bonosedidakit-glitch/DIDAKIT/DIDAKIT_SLDPRT_STL/base taleable2.SLDPRT

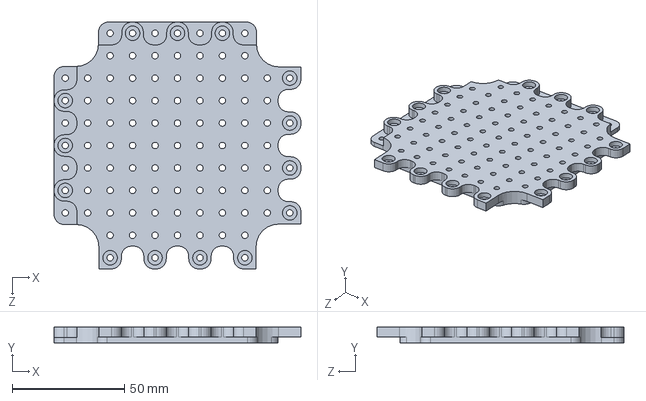
[picture p1: CAD file, 2026-11-09]
DIDAKIT_SLDPRT_STL/base taleable2.SLDPRT
110.0 x 7.00 x 110.0 mm
