bonosedidakit-glitch/DIDAKIT/kicad/CarroV1.0/CarroV1.0.step

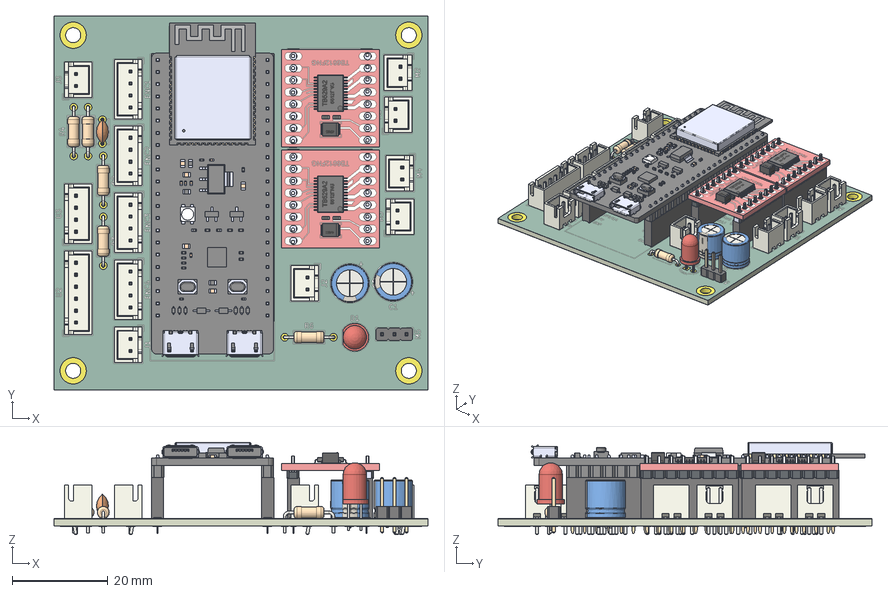
[picture p2: CAD file, 2026-11-10]
kicad/CarroV1.0/CarroV1.0.step
78.0 x 78.0 x 19.3 mm
R_Axial_DIN0207_L63mm_D25mm_P1016mm_Horizontal x 5
C_Disc_D50mm_W25mm_P500mm
JST_B4B_XH_A x 5
JST_B2B_XH_A x 7
CP_Radial_D80mm_P250mm x 2
PinHeader_1x03_P254mm_Vertical
JST_B6B_XH_A
PinSocket_1x08_P2.54mm_Vertical x 4
TB6612FNG v6 x 2
capacitor v2 x 2
capacitor_v1 v5 x 4
header_8 v1 x 4
ESP32-S3-DEVKITC-1-N8R2
PinSocket_1x22_P2.54mm_Vertical x 2
LED_D5.0mm
Car1120_copper
Car1120_silkscreen
Car1120_soldermask x 2
Car1120_PCB
