bonosedidakit-glitch/DIDAKIT/DIDAKIT_SLDPRT_STL/base_motor_1.SLDPRT

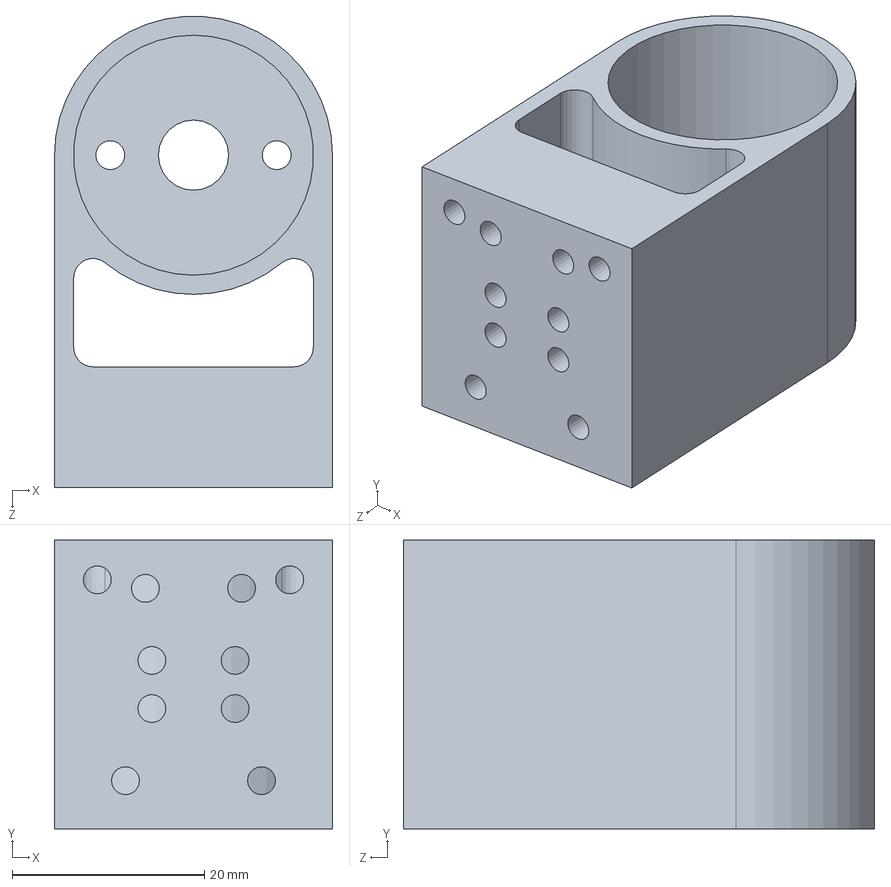
[picture p3: CAD file, 2026-11-09]
DIDAKIT_SLDPRT_STL/base_motor_1.SLDPRT
28.9 x 30.0 x 49.0 mm
