bonosedidakit-glitch/DIDAKIT/DIDAKIT_SLDPRT_STL/direccion_2.SLDPRT

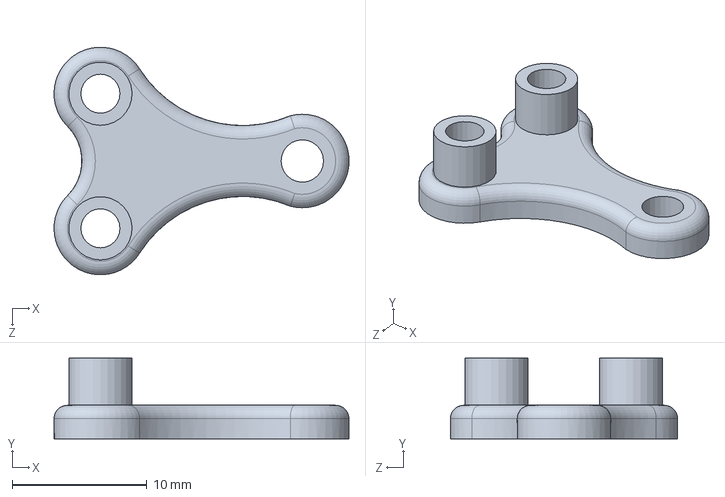
[picture p4: CAD file, 2026-11-09]
DIDAKIT_SLDPRT_STL/direccion_2.SLDPRT
21.9 x 6.00 x 16.9 mm
