bonosedidakit-glitch/DIDAKIT/DIDAKIT_SLDPRT_STL/ADNS-3080.SLDPRT

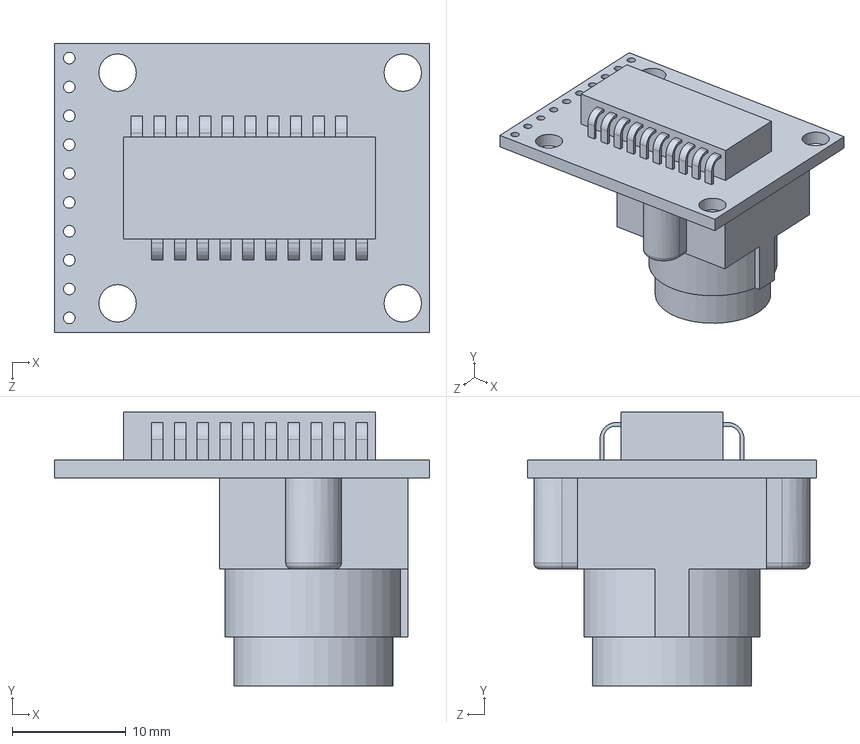
[picture p5: CAD file, 2026-11-09]
DIDAKIT_SLDPRT_STL/ADNS-3080.SLDPRT
33.0 x 24.1 x 25.4 mm
