bonosedidakit-glitch/DIDAKIT/DIDAKIT_SLDPRT_STL/direccion_3.SLDPRT

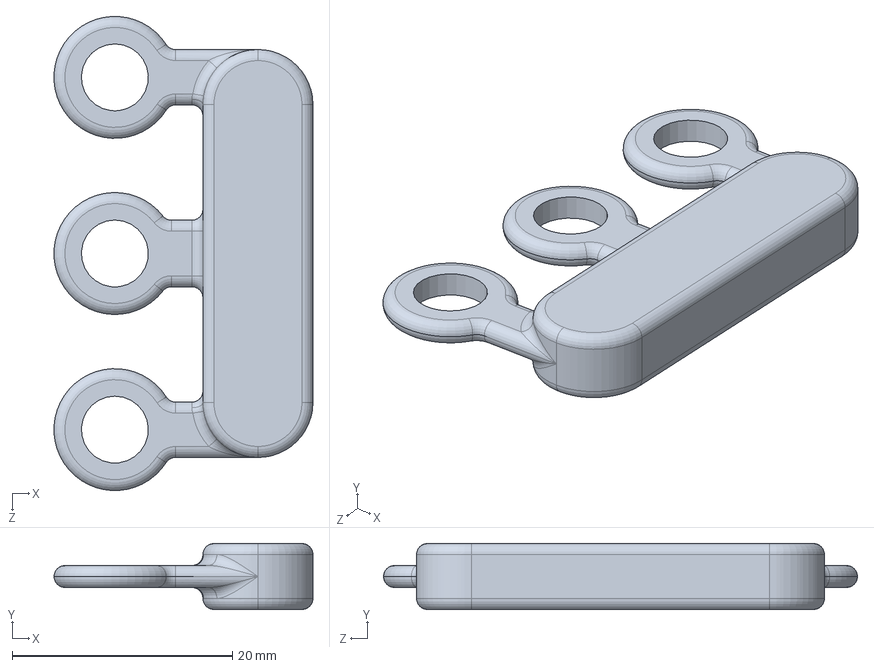
[picture p6: CAD file, 2026-11-09]
DIDAKIT_SLDPRT_STL/direccion_3.SLDPRT
23.5 x 6.00 x 43.1 mm
