bonosedidakit-glitch/DIDAKIT/DIDAKIT_SLDPRT_STL/base_servo_brazo.SLDPRT

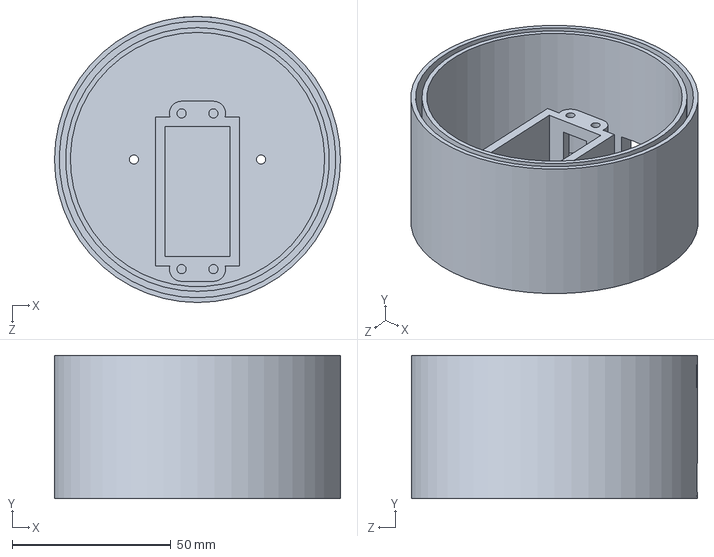
[picture p7: CAD file, 2026-11-09]
DIDAKIT_SLDPRT_STL/base_servo_brazo.SLDPRT
90.0 x 45.0 x 90.0 mm
