bonosedidakit-glitch/DIDAKIT/DIDAKIT_SLDPRT_STL/direccion_5.SLDPRT

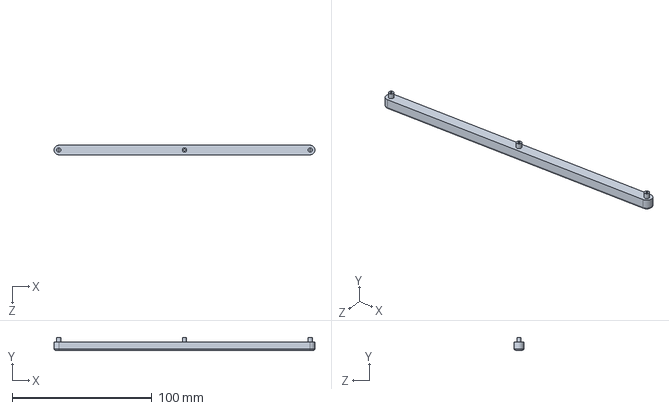
[picture p8: CAD file, 2026-11-09]
DIDAKIT_SLDPRT_STL/direccion_5.SLDPRT
186.9 x 9.00 x 6.90 mm
