bonosedidakit-glitch/DIDAKIT/DIDAKIT_SLDPRT_STL/direccion_31.SLDPRT

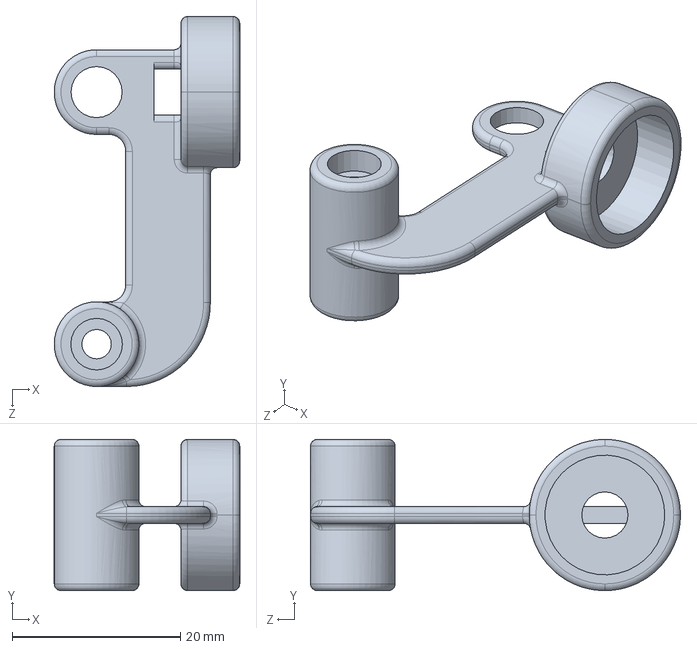
[picture p9: CAD file, 2026-11-09]
DIDAKIT_SLDPRT_STL/direccion_31.SLDPRT
22.1 x 18.0 x 44.0 mm
