bonosedidakit-glitch/DIDAKIT/DIDAKIT_SLDPRT_STL/base_IMU.SLDPRT

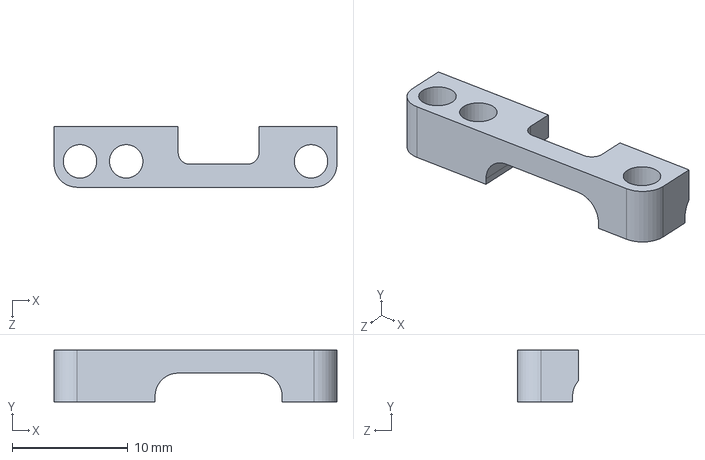
[picture p10: CAD file, 2026-11-09]
DIDAKIT_SLDPRT_STL/base_IMU.SLDPRT
24.5 x 4.50 x 5.25 mm
