bonosedidakit-glitch/DIDAKIT/DIDAKIT_SLDPRT_STL/base_servo_brazo_2.SLDPRT

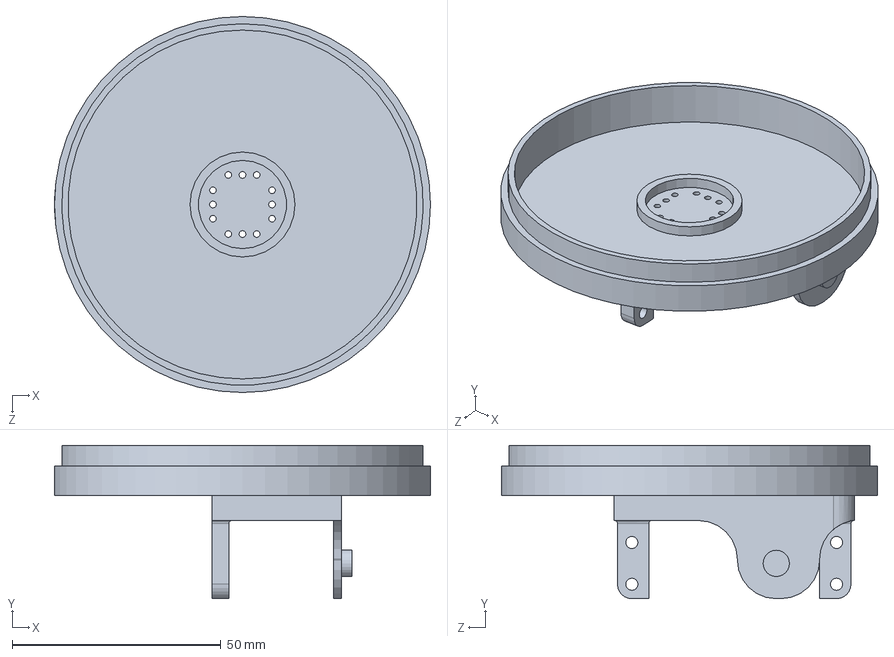
[picture p11: CAD file, 2026-11-09]
DIDAKIT_SLDPRT_STL/base_servo_brazo_2.SLDPRT
90.0 x 36.7 x 90.0 mm
