bonosedidakit-glitch/DIDAKIT/DIDAKIT_SLDPRT_STL/cople circular servo.SLDPRT

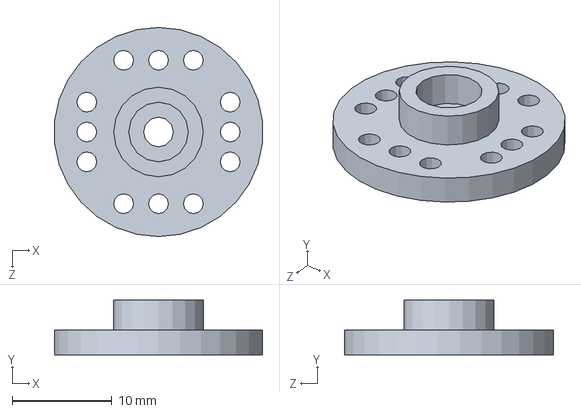
[picture p12: CAD file, 2026-11-09]
DIDAKIT_SLDPRT_STL/cople circular servo.SLDPRT
20.9 x 5.50 x 21.0 mm
