bonosedidakit-glitch/DIDAKIT/DIDAKIT_SLDPRT_STL/base taleable prove2.SLDPRT

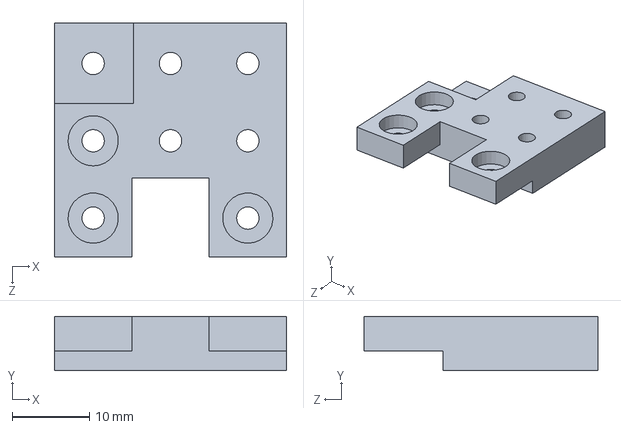
[picture p13: CAD file, 2026-11-09]
DIDAKIT_SLDPRT_STL/base taleable prove2.SLDPRT
30.0 x 7.00 x 30.2 mm
