bonosedidakit-glitch/DIDAKIT/DIDAKIT_SLDPRT_STL/base taleable prove1.SLDPRT

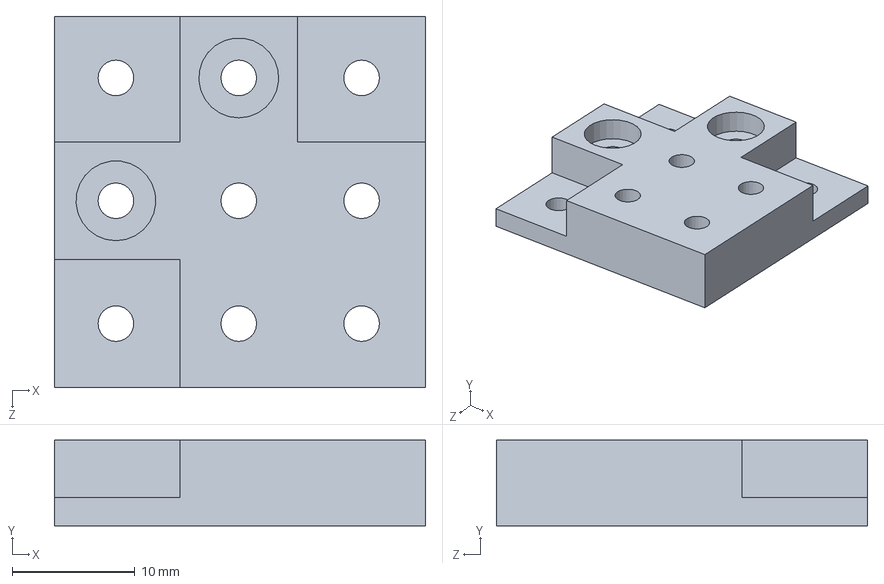
[picture p14: CAD file, 2026-11-09]
DIDAKIT_SLDPRT_STL/base taleable prove1.SLDPRT
30.2 x 7.00 x 30.2 mm
