bonosedidakit-glitch/DIDAKIT/DIDAKIT_SLDPRT_STL/direccion_12.SLDPRT

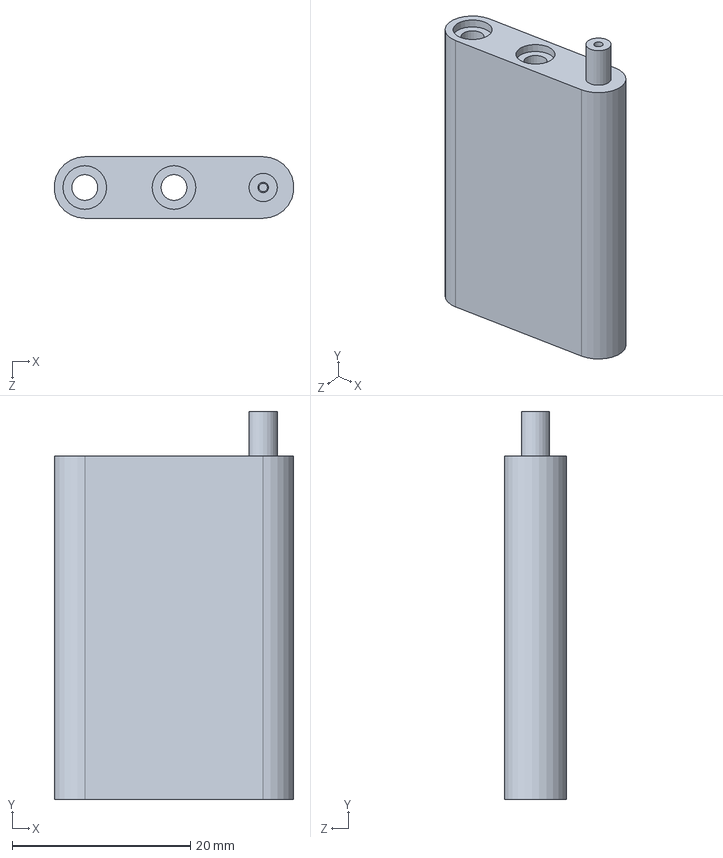
[picture p15: CAD file, 2026-11-09]
DIDAKIT_SLDPRT_STL/direccion_12.SLDPRT
26.8 x 43.5 x 6.90 mm
