bonosedidakit-glitch/DIDAKIT/DIDAKIT_SLDPRT_STL/brazo 2.SLDPRT

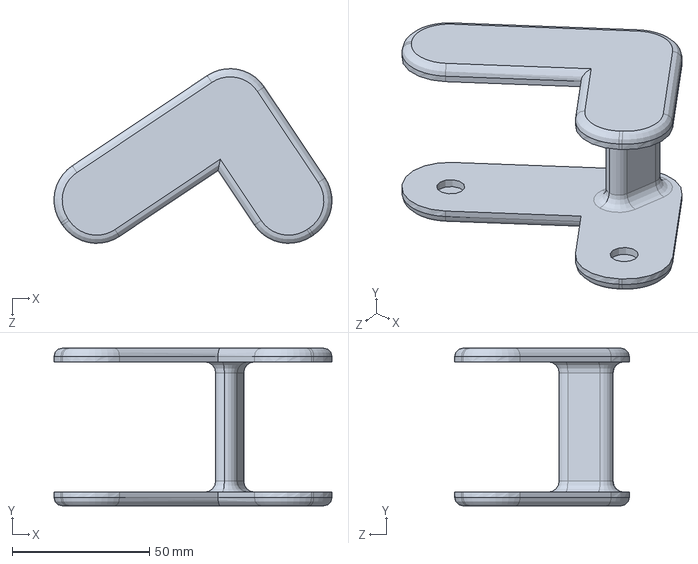
[picture p16: CAD file, 2026-11-09]
DIDAKIT_SLDPRT_STL/brazo 2.SLDPRT
101.4 x 57.5 x 63.7 mm
