bonosedidakit-glitch/DIDAKIT/DIDAKIT_SLDPRT_STL/direccion_4.SLDPRT

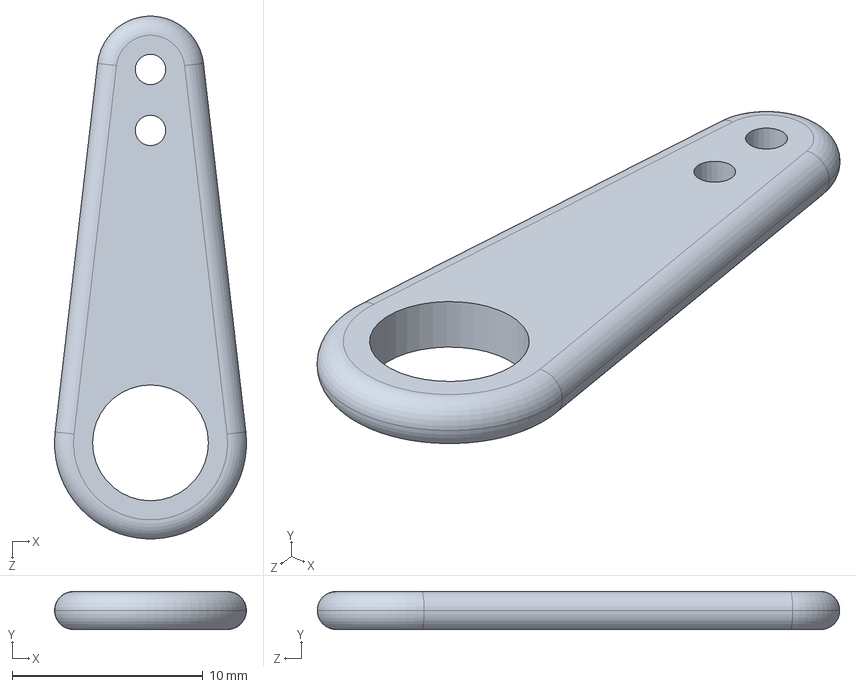
[picture p17: CAD file, 2026-11-09]
DIDAKIT_SLDPRT_STL/direccion_4.SLDPRT
10.1 x 2.00 x 27.4 mm
