bonosedidakit-glitch/DIDAKIT/DIDAKIT_SLDPRT_STL/direccion_1.SLDPRT

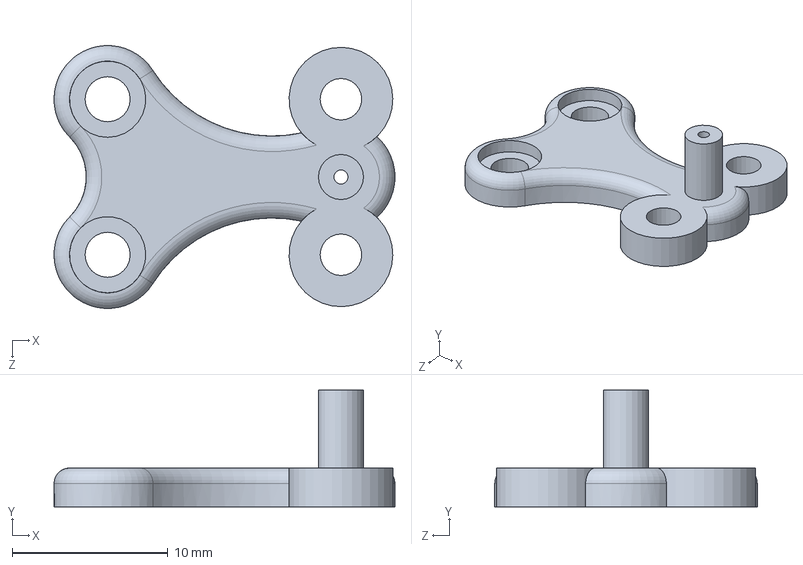
[picture p18: CAD file, 2026-11-09]
DIDAKIT_SLDPRT_STL/direccion_1.SLDPRT
21.9 x 7.50 x 16.9 mm
