bonosedidakit-glitch/DIDAKIT/DIDAKIT_SLDPRT_STL/direccion_22.SLDPRT

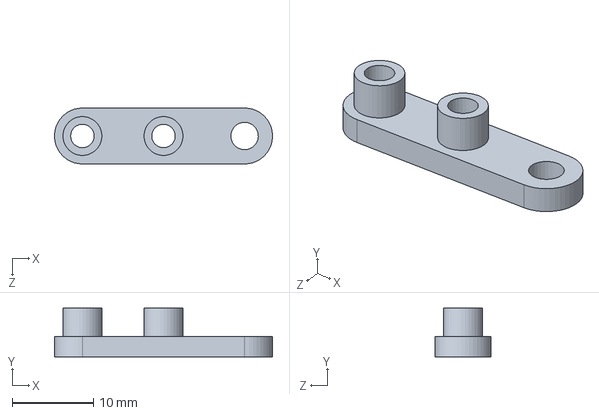
[picture p19: CAD file, 2026-11-09]
DIDAKIT_SLDPRT_STL/direccion_22.SLDPRT
26.9 x 6.00 x 6.90 mm
