bonosedidakit-glitch/DIDAKIT/DIDAKIT_SLDPRT_STL/direccion_11.SLDPRT

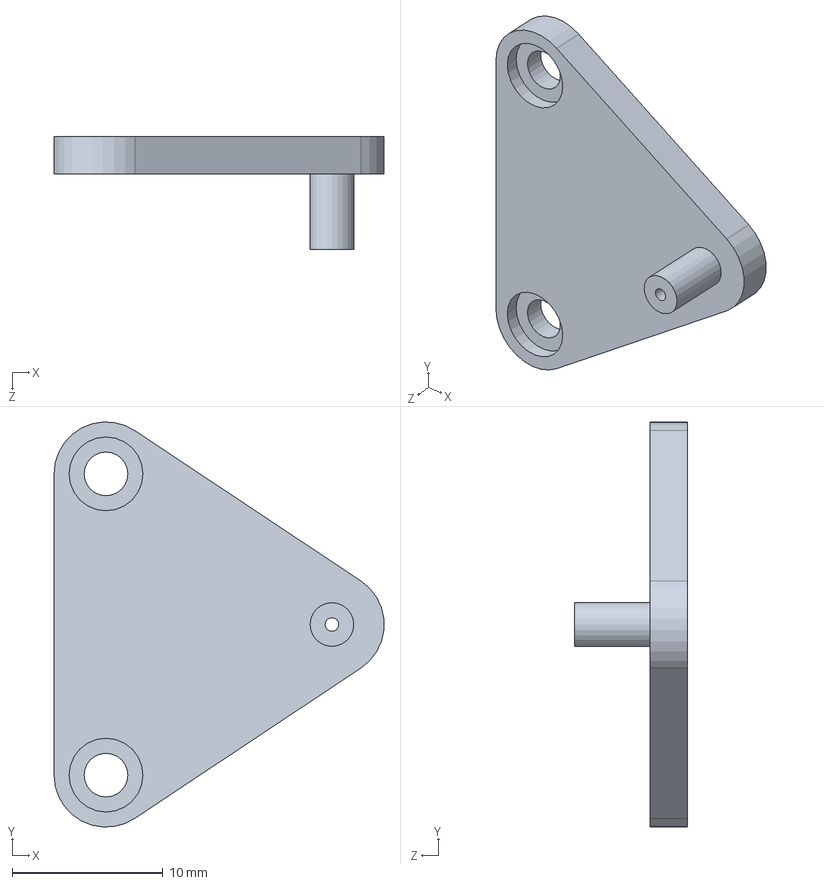
[picture p20: CAD file, 2026-11-09]
DIDAKIT_SLDPRT_STL/direccion_11.SLDPRT
21.9 x 26.9 x 7.50 mm
