bonosedidakit-glitch/DIDAKIT/DIDAKIT_SLDPRT_STL/direccion_12_toltest.SLDPRT

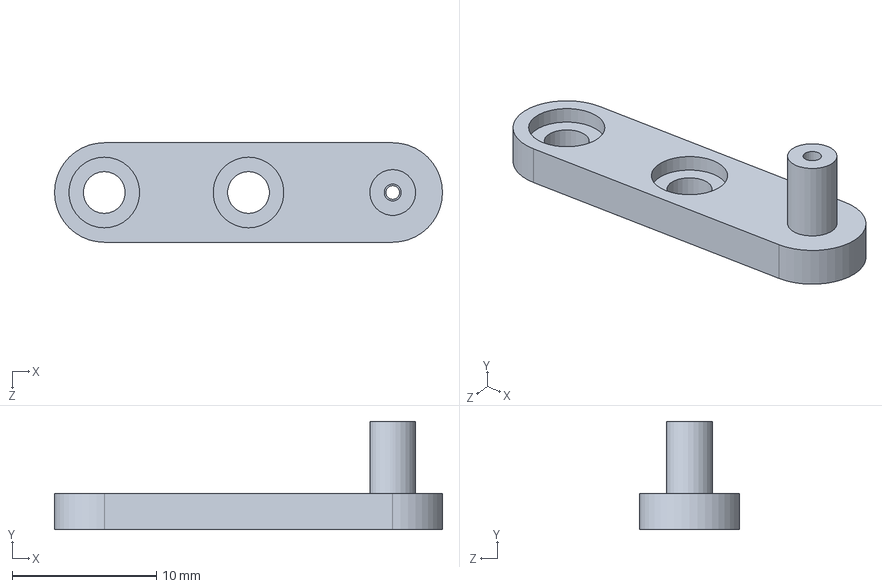
[picture p21: CAD file, 2026-11-09]
DIDAKIT_SLDPRT_STL/direccion_12_toltest.SLDPRT
26.9 x 7.50 x 6.90 mm
