bonosedidakit-glitch/DIDAKIT/DIDAKIT_SLDPRT_STL/base taleable.SLDPRT

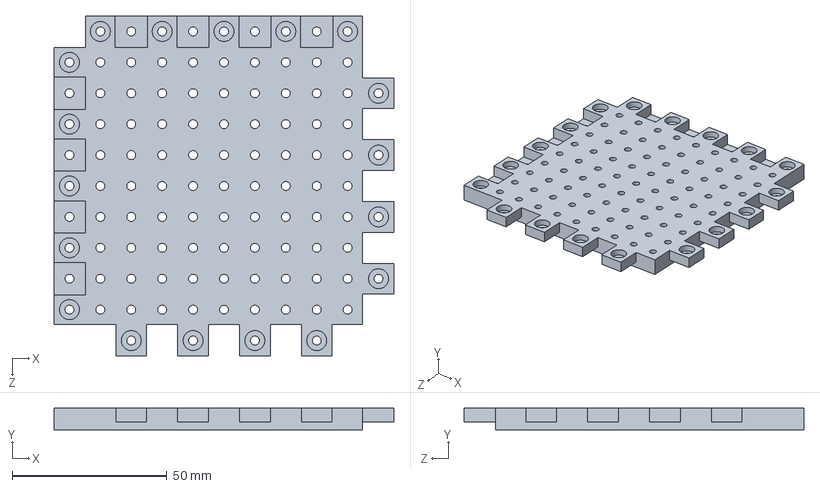
[picture p22: CAD file, 2026-11-09]
DIDAKIT_SLDPRT_STL/base taleable.SLDPRT
110.0 x 7.00 x 110.0 mm
