bonosedidakit-glitch/DIDAKIT/DIDAKIT_SLDPRT_STL/balero rueda loca.SLDPRT

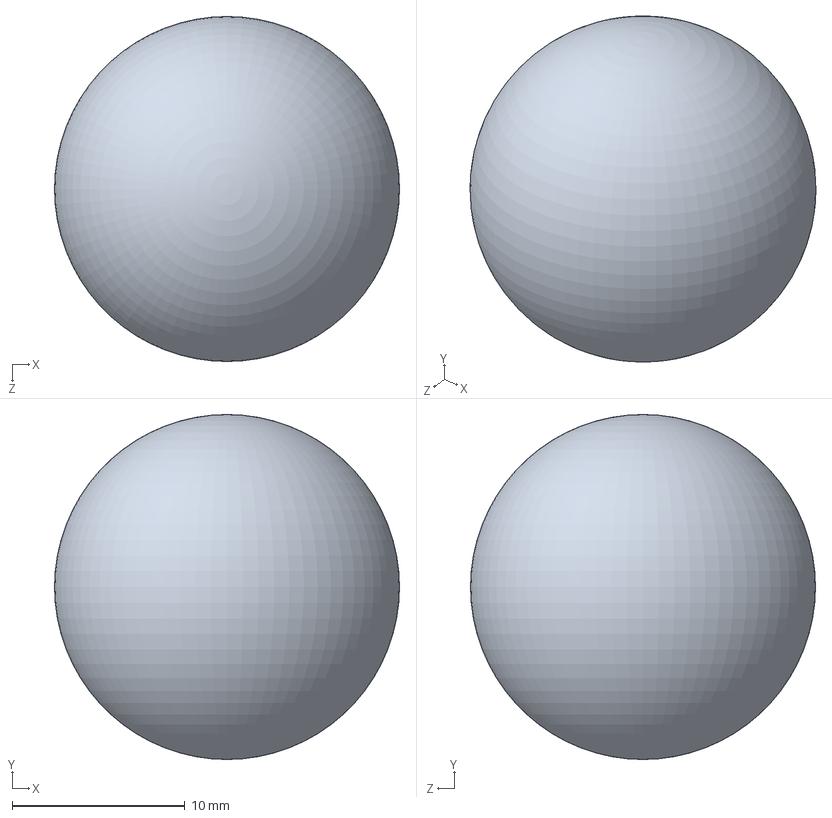
[picture p23: CAD file, 2026-11-09]
DIDAKIT_SLDPRT_STL/balero rueda loca.SLDPRT
20.0 x 20.0 x 20.0 mm
