bonosedidakit-glitch/DIDAKIT/DIDAKIT_SLDPRT_STL/base_servo_direccion.SLDPRT

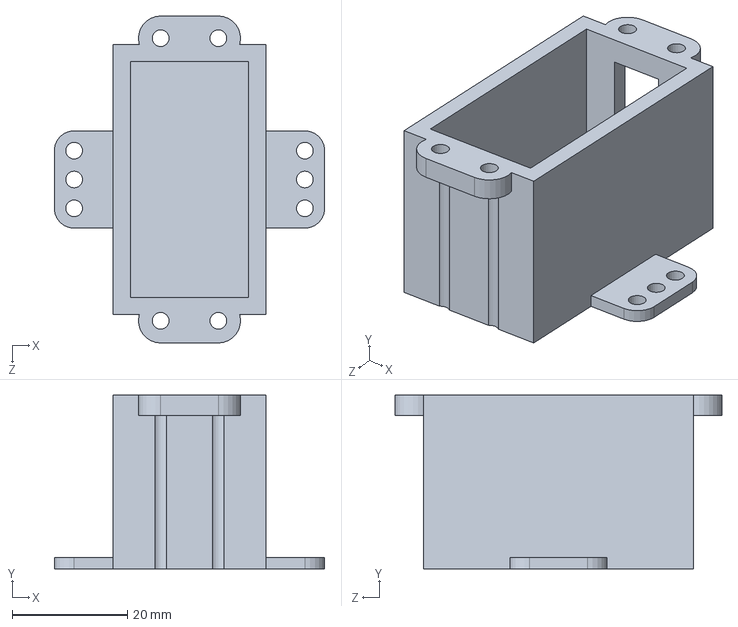
[picture p24: CAD file, 2026-11-09]
DIDAKIT_SLDPRT_STL/base_servo_direccion.SLDPRT
46.9 x 30.1 x 56.7 mm
