bonosedidakit-glitch/DIDAKIT/DIDAKIT_SLDPRT_STL/base_IMUvert.SLDPRT

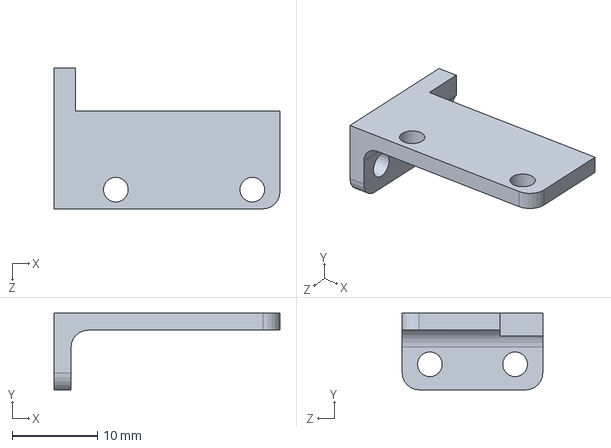
[picture p25: CAD file, 2026-11-09]
DIDAKIT_SLDPRT_STL/base_IMUvert.SLDPRT
26.5 x 9.00 x 16.5 mm
