bonosedidakit-glitch/DIDAKIT/DIDAKIT_SLDPRT_STL/direccion_21.SLDPRT

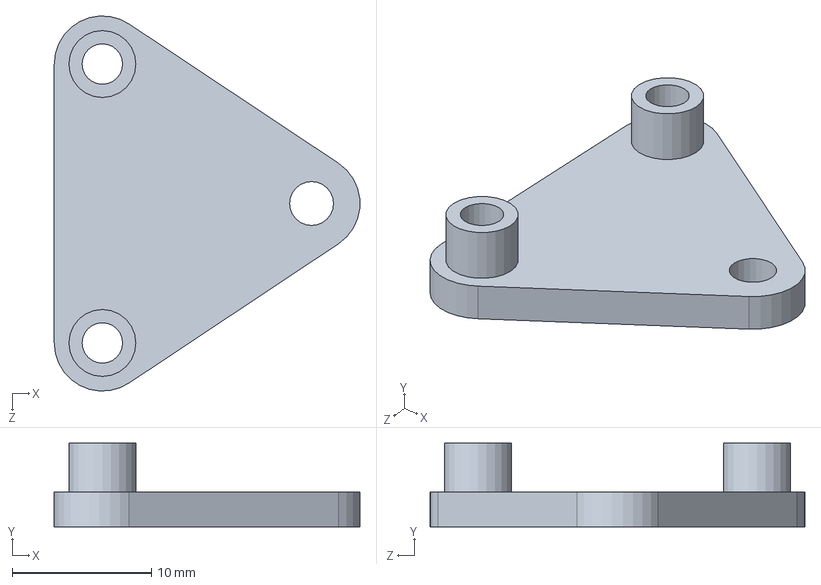
[picture p26: CAD file, 2026-11-09]
DIDAKIT_SLDPRT_STL/direccion_21.SLDPRT
21.9 x 6.00 x 26.9 mm
