bonosedidakit-glitch/DIDAKIT/DIDAKIT_SLDPRT_STL/brazo_dir_2.SLDASM

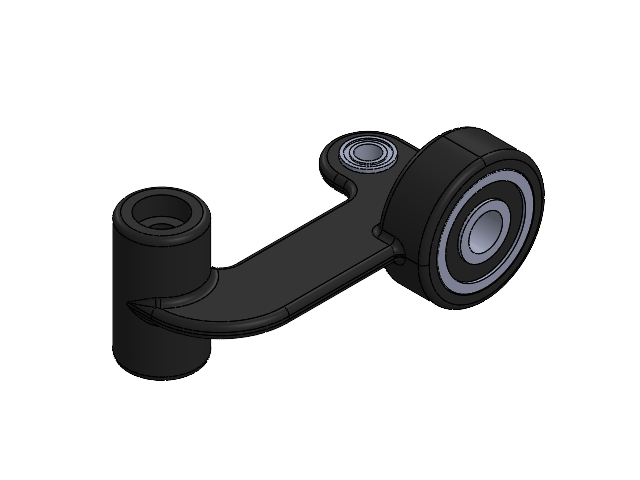
[picture p27: CAD file, 2026-11-09]
DIDAKIT_SLDPRT_STL/brazo_dir_2.SLDASM
direccion_31
rodamiento14_5_5
rodamiento6_3_2.5 x 2
