bonosedidakit-glitch/DIDAKIT/DIDAKIT_SLDPRT_STL/ADNS3050_JST.SLDASM

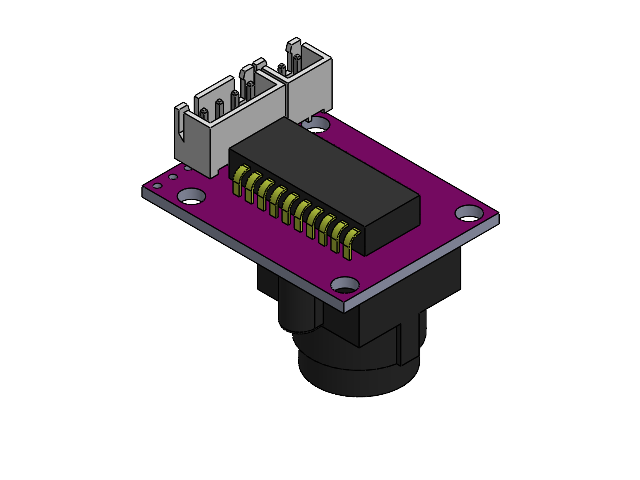
[picture p28: CAD file, 2026-11-09]
DIDAKIT_SLDPRT_STL/ADNS3050_JST.SLDASM
ADNS-3080
JST - XH - Thru (V) - 2Pin - 2.54mm.stp
JST - XH - Thru (V) - 4Pin - 2.54mm.stp
