bonosedidakit-glitch/DIDAKIT/DIDAKIT_SLDPRT_STL/brazo_dir_1.SLDASM

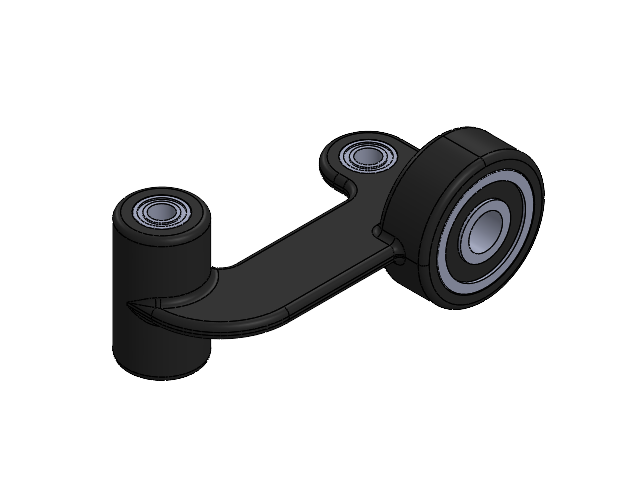
[picture p29: CAD file, 2026-11-09]
DIDAKIT_SLDPRT_STL/brazo_dir_1.SLDASM
direccion_31
rodamiento14_5_5
rodamiento6_3_2.5 x 2
