bonosedidakit-glitch/DIDAKIT/(list of files, cad)

Other CAD files:
DIDAKIT_SLDPRT_STL/18650 Battery Holder 4x.STEP
DIDAKIT_SLDPRT_STL/base taleable prove1.STL
DIDAKIT_SLDPRT_STL/base taleable prove2.STL
DIDAKIT_SLDPRT_STL/base taleable2.STL
DIDAKIT_SLDPRT_STL/base_IMU.STL
DIDAKIT_SLDPRT_STL/base_IMUvert.STL
DIDAKIT_SLDPRT_STL/base_motor_1.3mf
DIDAKIT_SLDPRT_STL/base_motor_1.STL
DIDAKIT_SLDPRT_STL/base_servo_brazo.STL
DIDAKIT_SLDPRT_STL/base_servo_brazo_2.STL
DIDAKIT_SLDPRT_STL/base_servo_direccion.STL
DIDAKIT_SLDPRT_STL/direccion_1.STL
DIDAKIT_SLDPRT_STL/direccion_12.STL
DIDAKIT_SLDPRT_STL/direccion_12_toltest.STL
DIDAKIT_SLDPRT_STL/direccion_2.STL
DIDAKIT_SLDPRT_STL/direccion_22.STL
DIDAKIT_SLDPRT_STL/direccion_3.STL
DIDAKIT_SLDPRT_STL/direccion_31.STL
DIDAKIT_SLDPRT_STL/direccion_4.STL
DIDAKIT_SLDPRT_STL/direccion_5.STL
