bonosedidakit-glitch/DIDAKIT/Manual Armado DIDAKIT.pdf

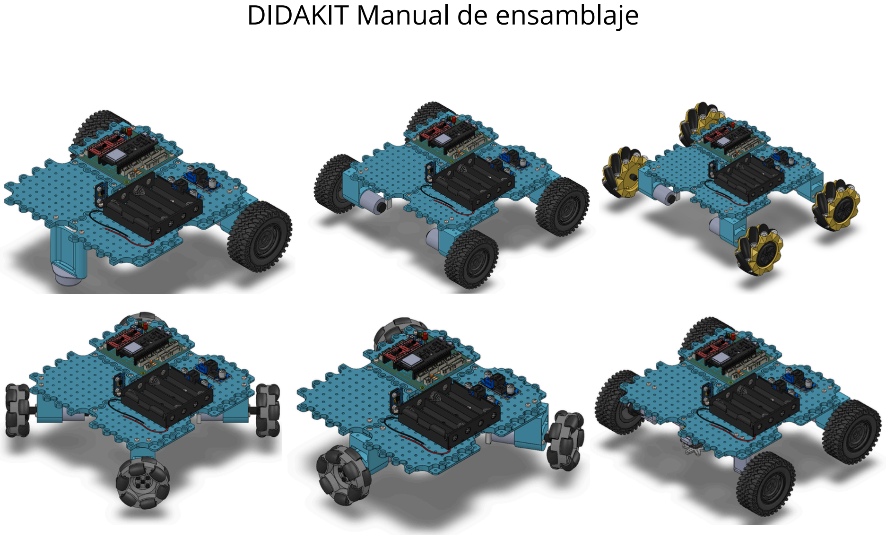
[picture p30: page 1]

DIDAKIT Manual de ensamblaje

## Indice

Diferencial
Skidd-Steer
Omnidireccional (Mecanum)
Omnidireccional (4 llantas) Omnidireccional (3 llantas) Tipo coche

579

11
13
15

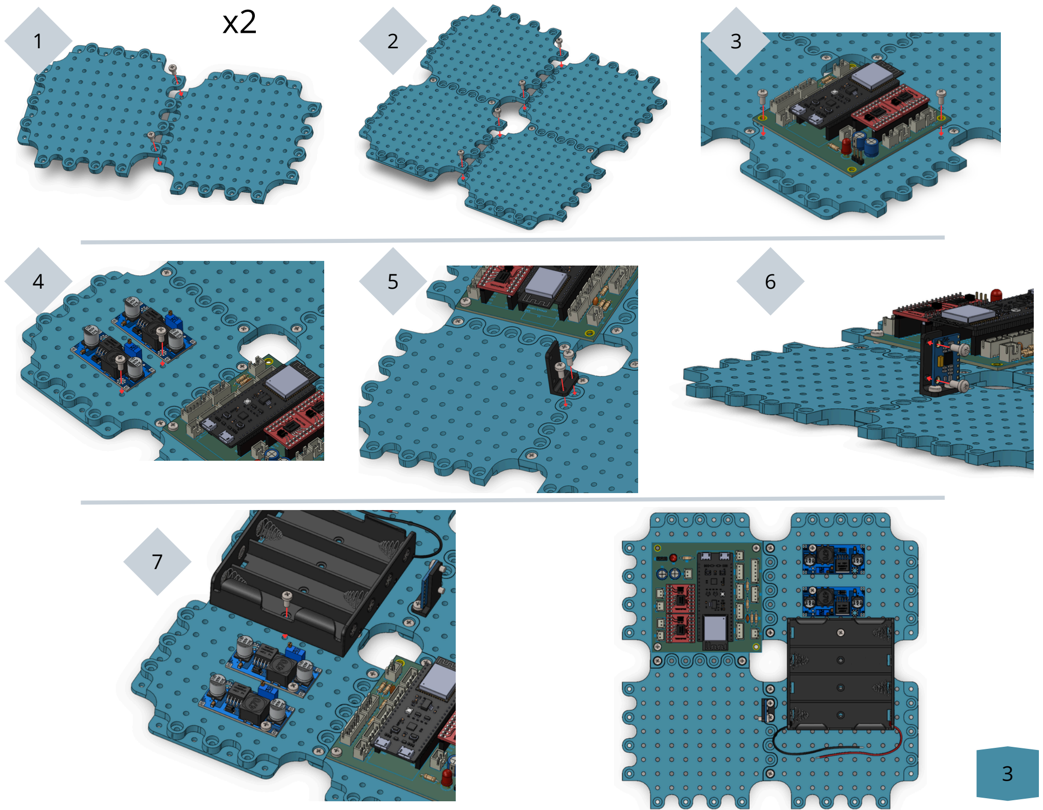
[picture p31: page 3]

4

5

6

7

x2

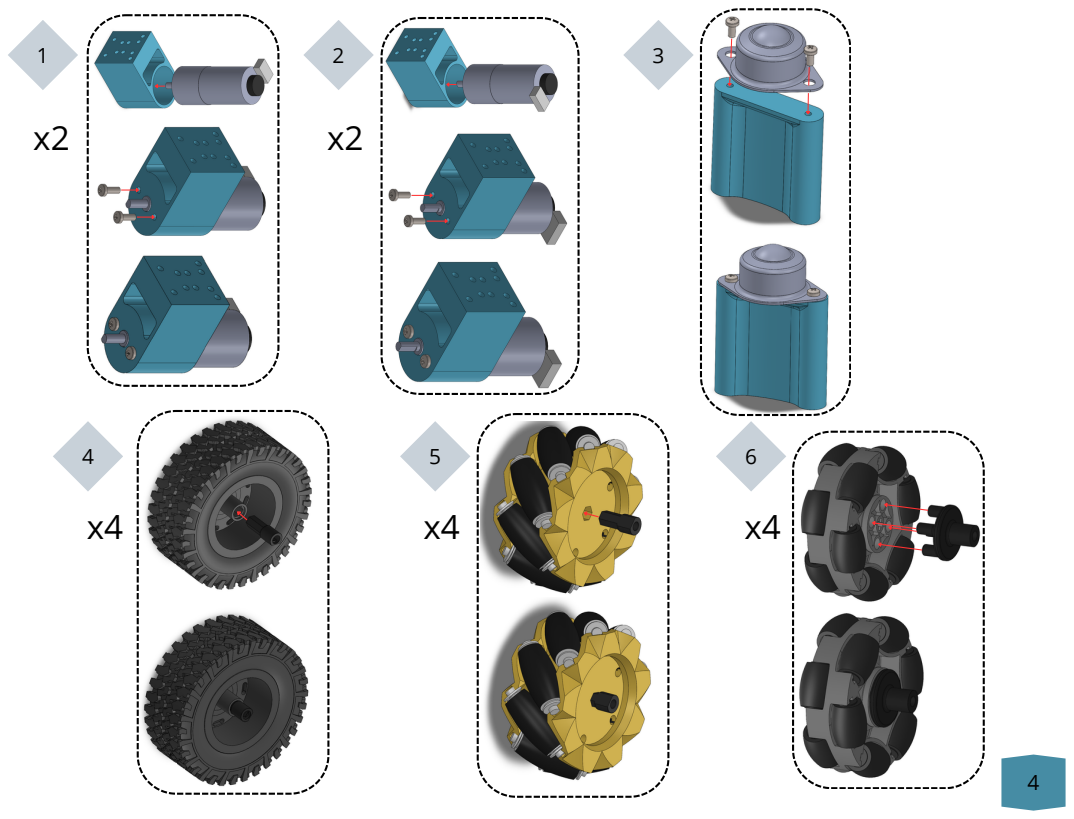
[picture p32: page 4]

# Diferencial

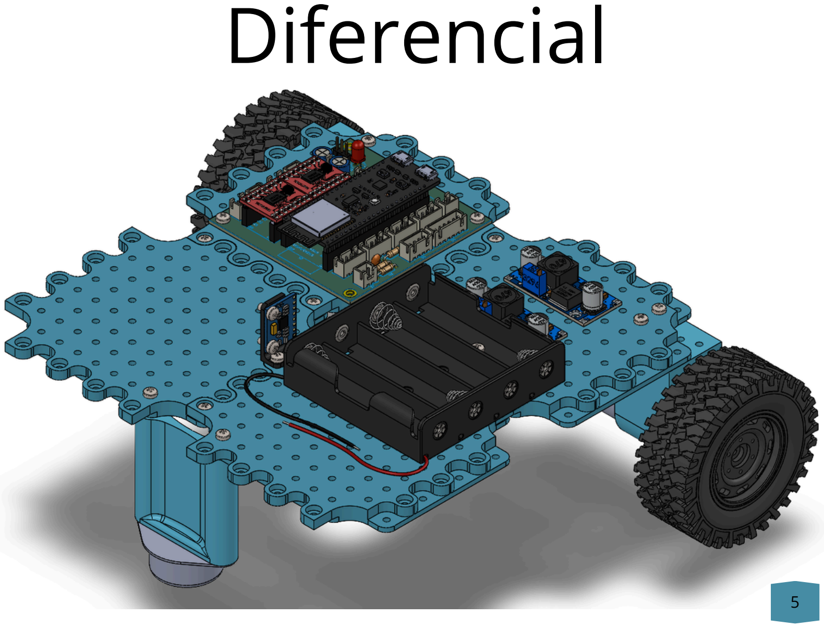
[picture p33: page 5]
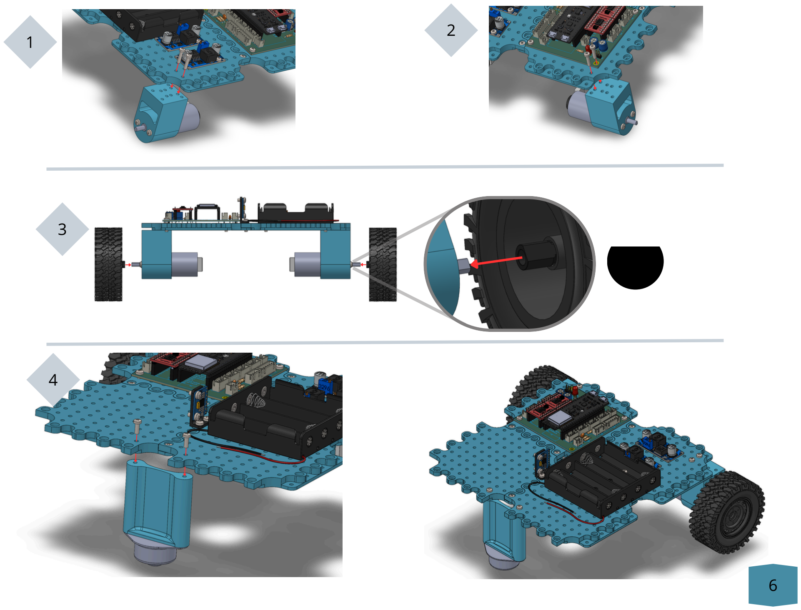
[picture p34: page 6]

1

2

3

4

# Skidd-Steer

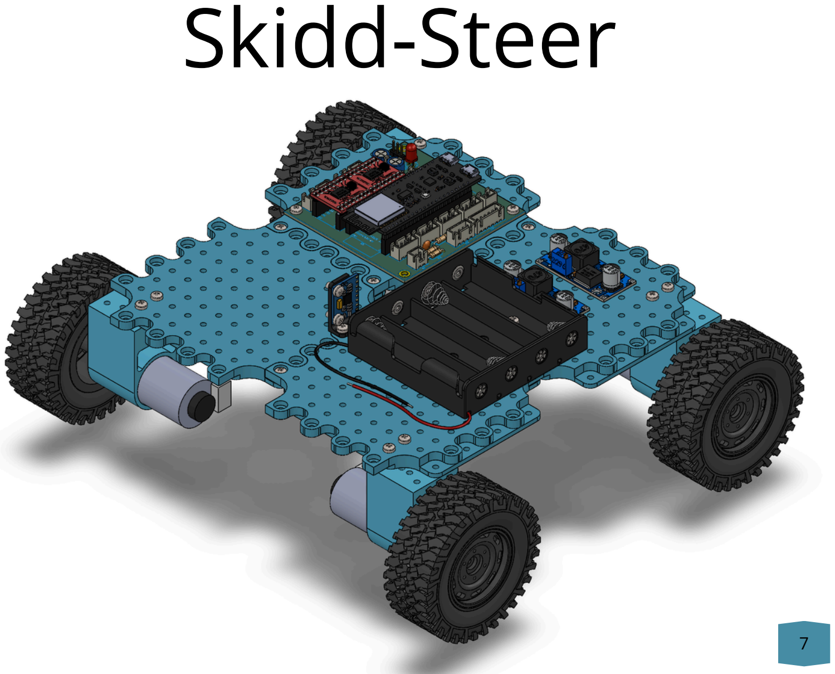
[picture p35: page 7]
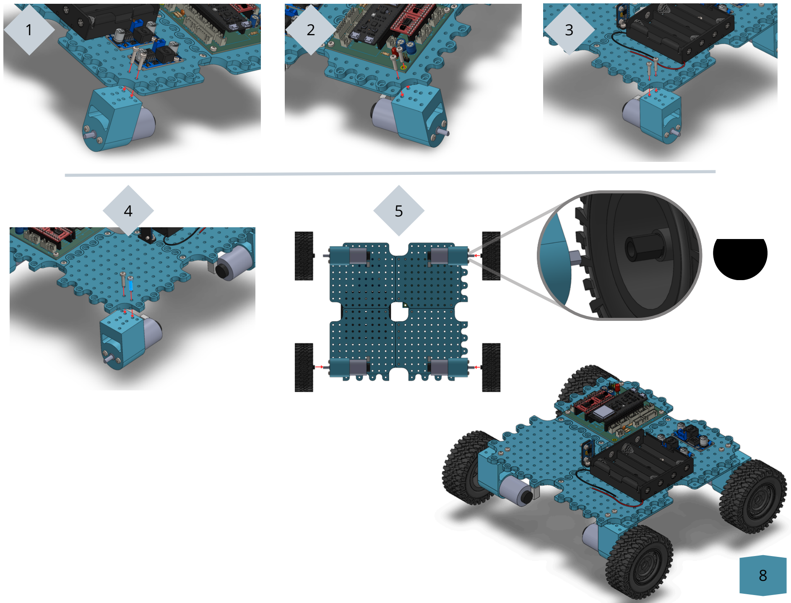
[picture p36: page 8]

1

2

3

4

5

# Omnidireccional (Mecanum)

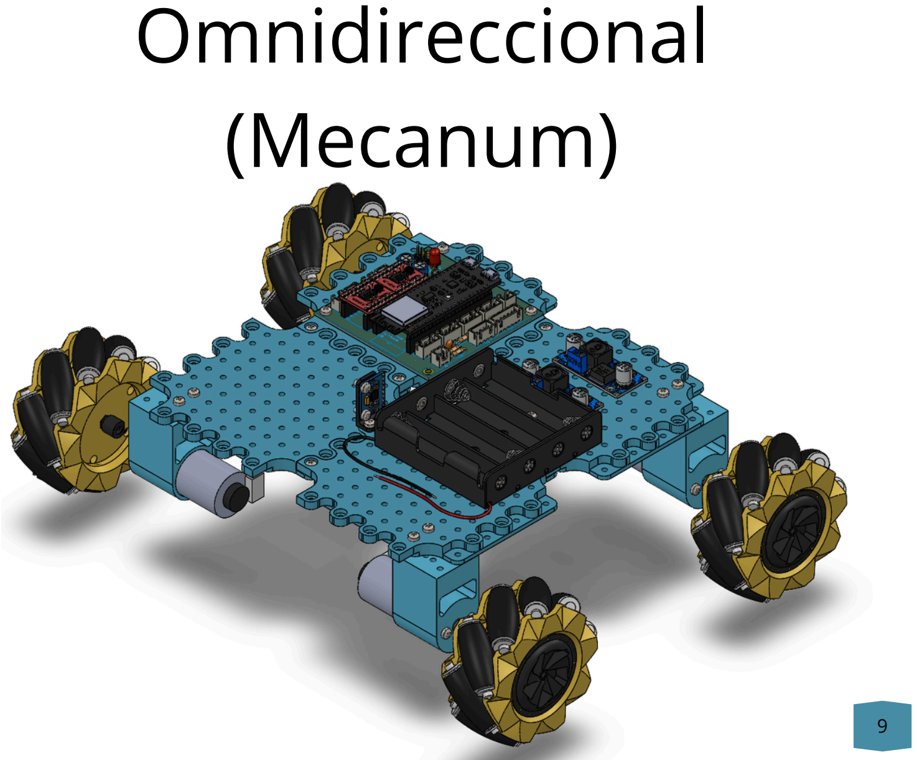
[picture p37: page 9]
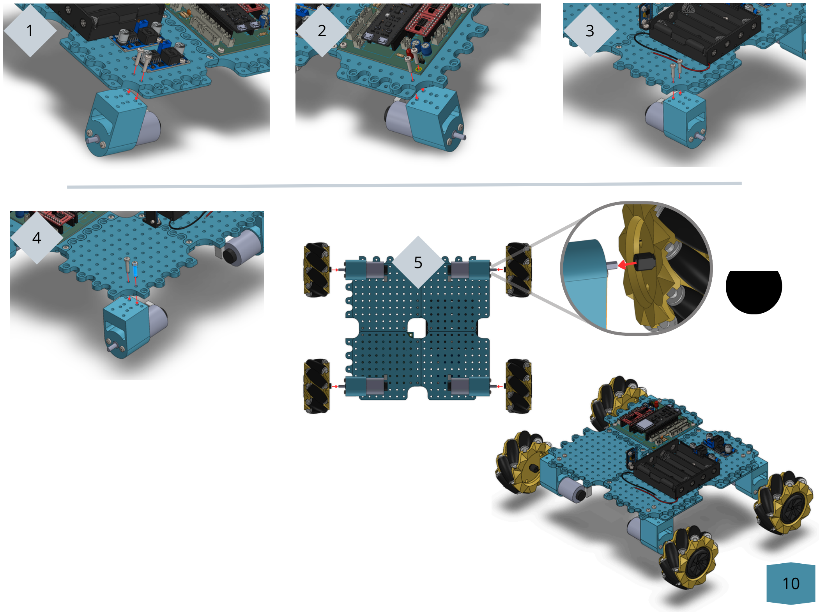
[picture p38: page 10]

4

1

2

3

5

# Omnidireccional (4 llantas)

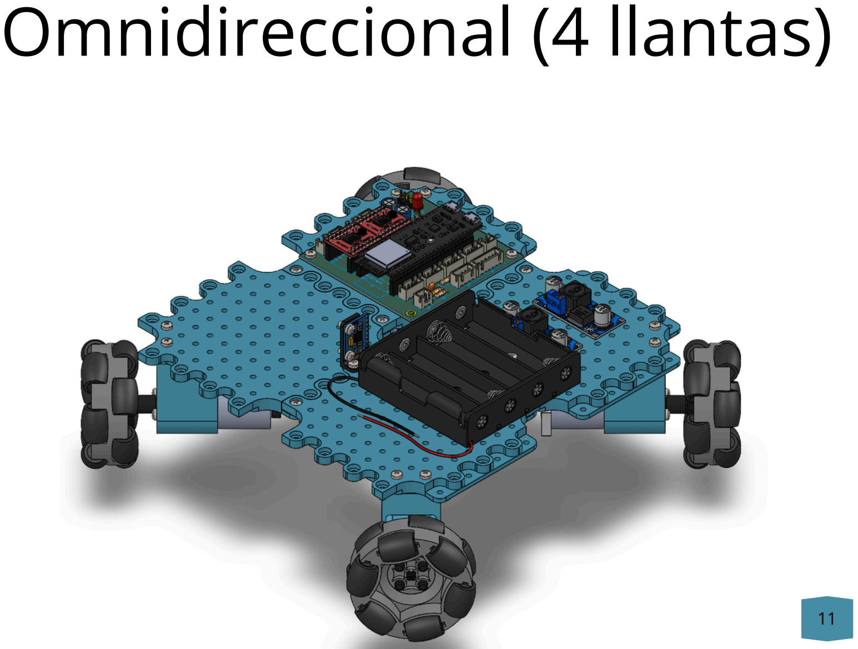
[picture p39: page 11]
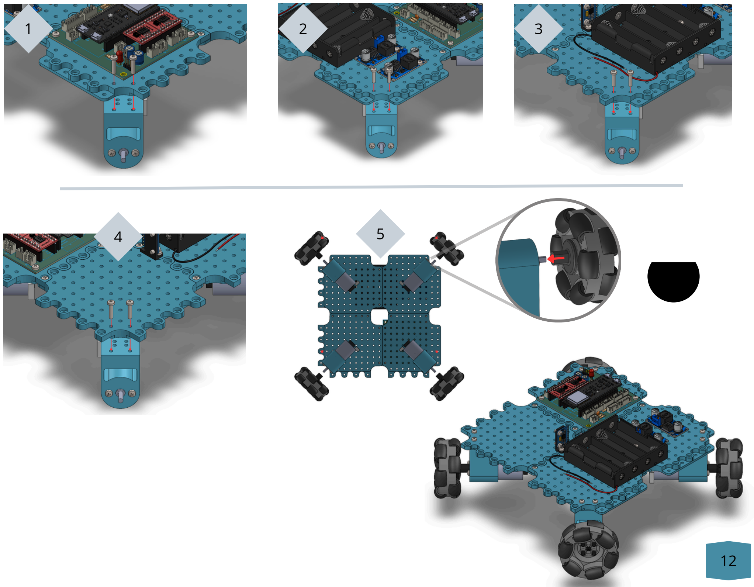
[picture p40: page 12]

1 | 2 | 3
4 | 5

# Omnidireccional (3 llantas)

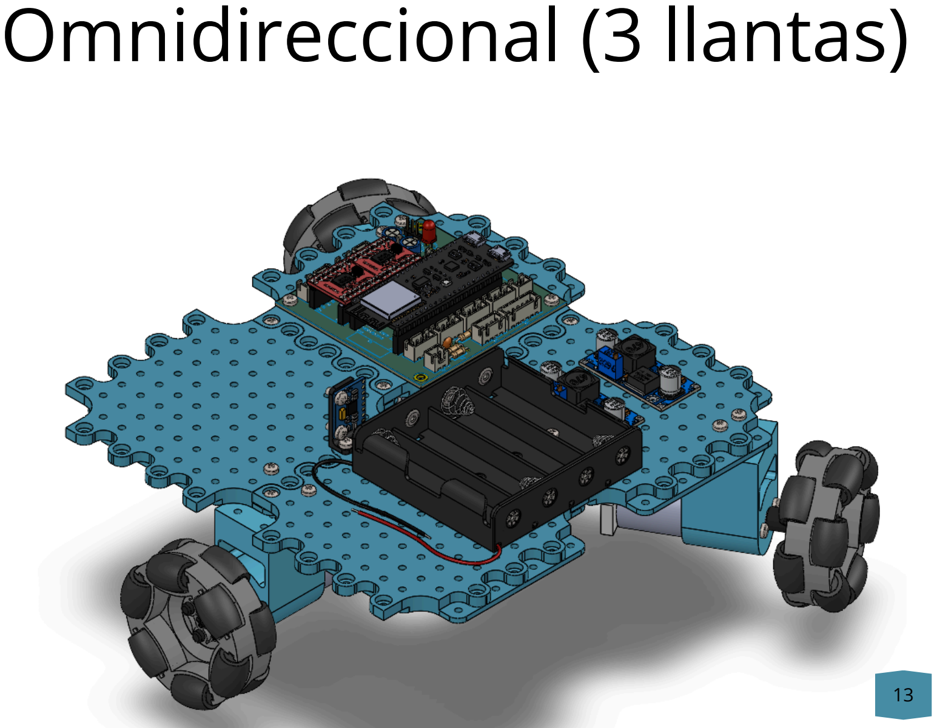
[picture p41: page 13]
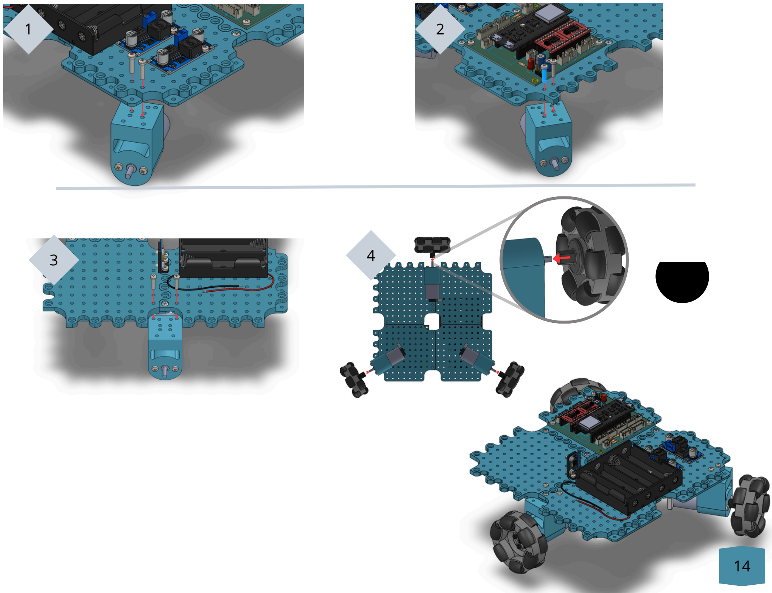
[picture p42: page 14]

1

2

3

4

# Tipo coche

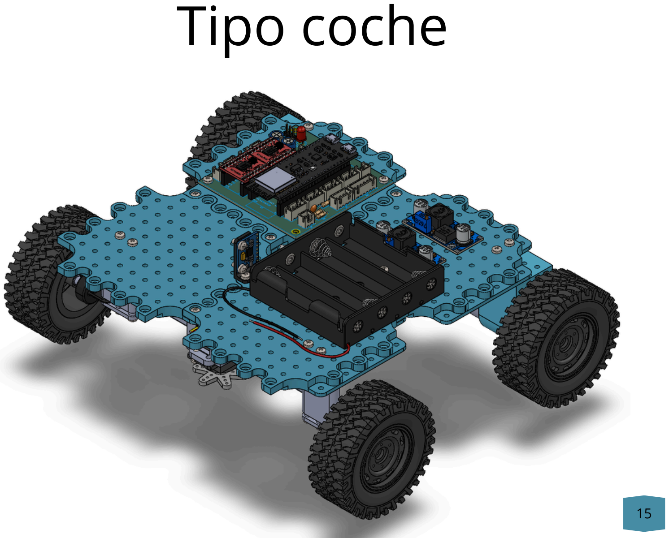
[picture p43: page 15]
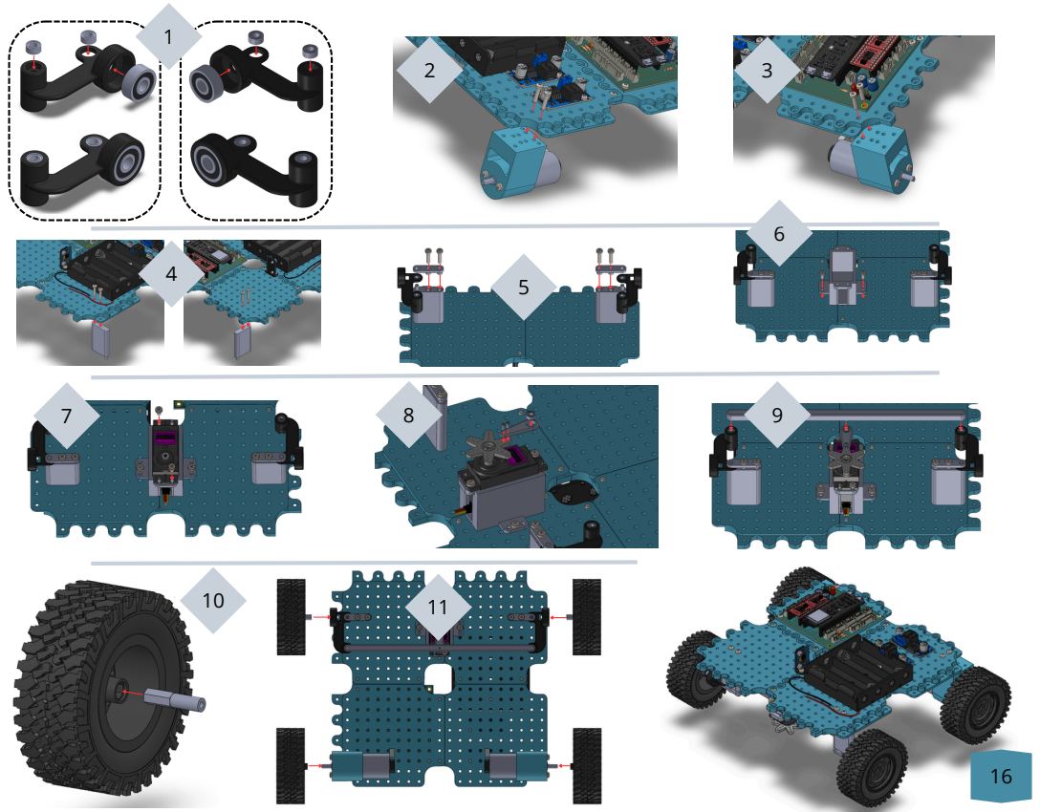
[picture p44: page 16]
