bonosedidakit-glitch/DIDAKIT/kicad/CarroV1.0/CarroV1.0.kicad_pcb

## KiCad design kicad/CarroV1.0/CarroV1.0.kicad_pcb (2026-11-10)

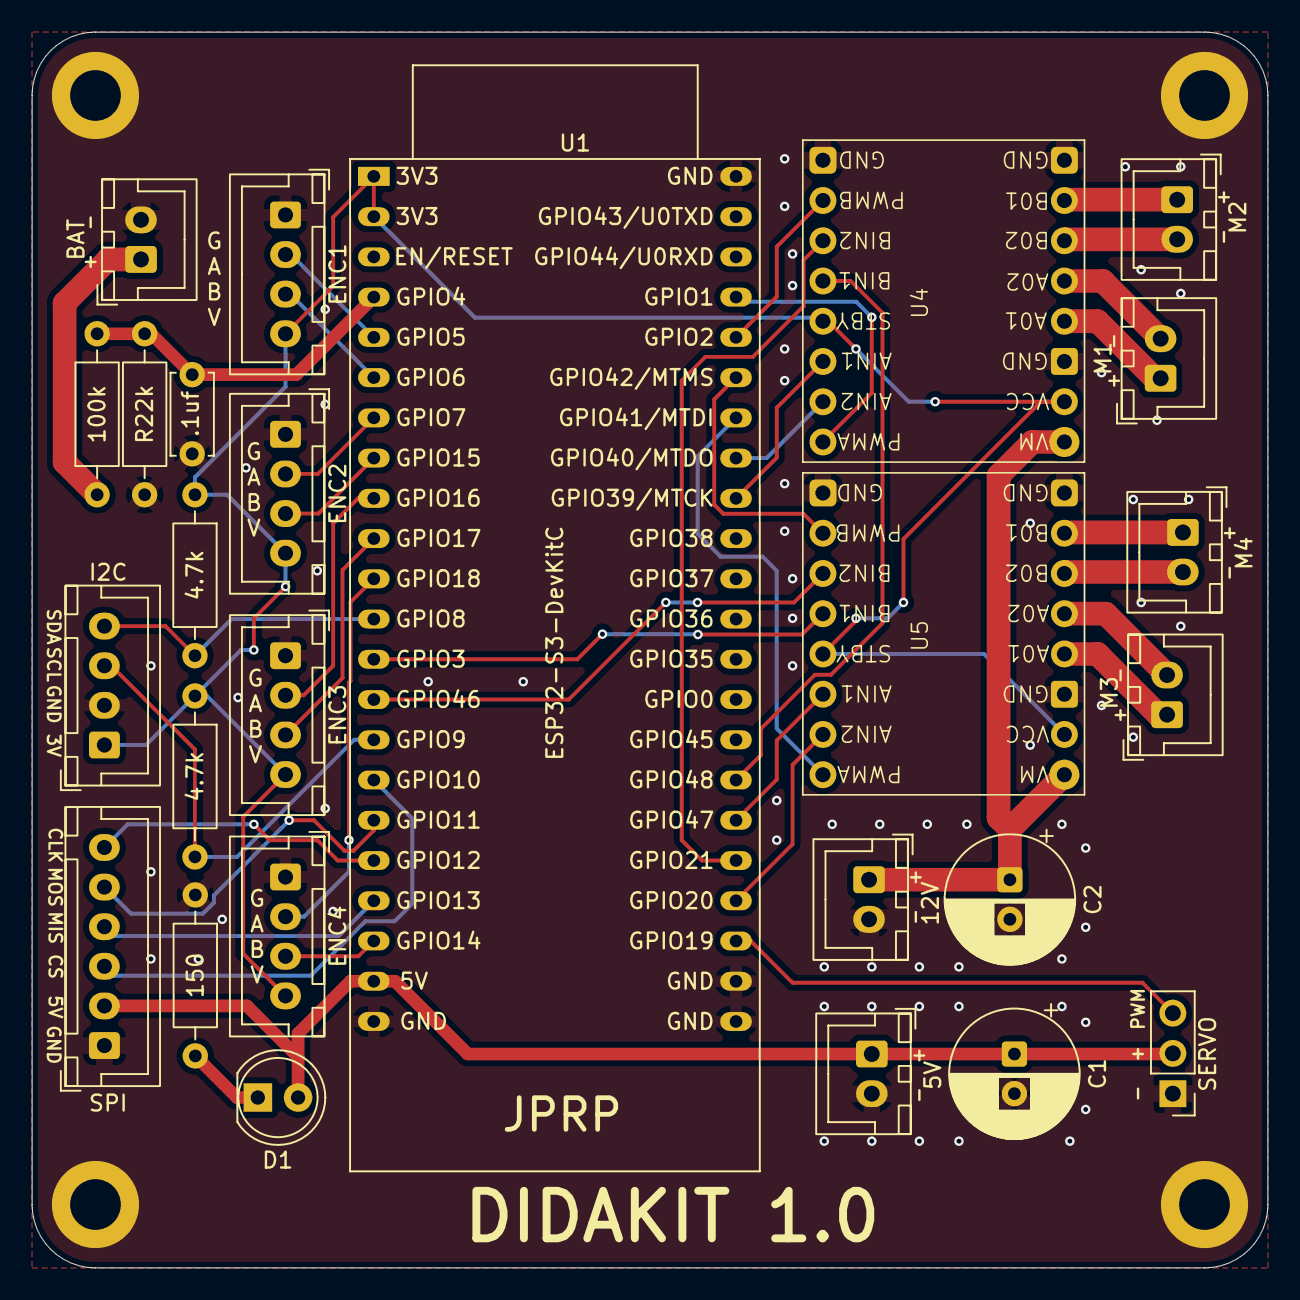
[picture p45: board CarroV1.0.kicad_pcb from above]

Board: 2 copper layers, 78.0 x 78.0 mm, 26 parts (0 on the bottom side), 42 nets.

Parts:
4.7k: 4.7K; R_Axial_DIN0207_L6.3mm_D2.5mm_P10.16mm_Horizontal
4.7k#2: 4.7k; R_Axial_DIN0207_L6.3mm_D2.5mm_P10.16mm_Horizontal
5V: INPUT 5V; JST_XH_B2B-XH-A_1x02_P2.50mm_Vertical
12V: INPUT 12V; JST_XH_B2B-XH-A_1x02_P2.50mm_Vertical
100k: 100k; R_Axial_DIN0207_L6.3mm_D2.5mm_P10.16mm_Horizontal
150: 150; R_Axial_DIN0207_L6.3mm_D2.5mm_P10.16mm_Horizontal
.1uf: 100nF; C_Disc_D5.0mm_W2.5mm_P5.00mm
BAT: INPUT_battery; JST_XH_B2B-XH-A_1x02_P2.50mm_Vertical
C1, C2: 1000uF; CP_Radial_D8.0mm_P2.50mm
D1: LED; LED_D5.0mm
ENC1, ENC2, ENC3, ENC4: JST_XH_B4B-XH-A_1x04_P2.50mm_Vertical
I2C: JST_XH_B4B-XH-A_1x04_P2.50mm_Vertical
M1, M2, M3, M4: JST_XH_B2B-XH-A_1x02_P2.50mm_Vertical
R22k: 22k; R_Axial_DIN0207_L6.3mm_D2.5mm_P10.16mm_Horizontal
SERVO: Motor_Servo; PinHeader_1x03_P2.54mm_Vertical
SPI: JST_XH_B6B-XH-A_1x06_P2.50mm_Vertical
U1: ESP32-S3-DevKitC
U4, U5: TB6612FNG

Connections:
3.3v: 4.7k.1, 4.7k#2.1, ENC1.4 (VCC), ENC2.4 (VCC), ENC3.4 (VCC), ENC4.4 (VCC), I2C.1 (VCC), U1.1 (3V3), U1.2 (3V3), U4.2 (VCC), U4.12 (STBY), U5.2 (VCC), U5.12 (STBY)
5v: 5V.1, C1.1, D1.2 (A), SERVO.2 (+), SPI.2 (5V), U1.21 (5V)
12v: 12V.1, C2.1, U4.1 (VM), U5.1 (VM)
BAT: 100k.2, .1uf.2, R22k.2, U1.4 (GPIO4/ADC1_CH3)
DIRM11: U1.36 (GPIO39/MTCK), U4.11 (AIN1)
DIRM12: U1.37 (GPIO40/MTDO), U4.10 (AIN2)
DIRM21: U1.29 (GPIO48), U4.13 (BIN1)
DIRM22: U1.27 (GPIO21), U4.14 (BIN2)
DIRM31: U1.28 (GPIO47), U5.11 (AIN1)
DIRM32: U1.26 (GPIO20/USB_D+), U5.10 (AIN2)
DIRM41: U1.13 (GPIO3/ADC1_CH2), U5.13 (BIN1)
DIRM42: U1.14 (GPIO46), U5.14 (BIN2)
GND: 5V.2, 12V.2, 150.1, .1uf.1, BAT.2, C1.2, C2.2, ENC1.1 (GND), ENC2.1 (GND), ENC3.1 (GND), ENC4.1 (GND), I2C.2 (GND), R22k.1, SERVO.1 (PWM), SPI.1 (GND), U1.22 (GND), U1.23 (GND), U1.24 (GND), U1.44 (GND), U4.3 (GND), U4.8 (GND), U4.16 (GND), U5.3 (GND), U5.8 (GND), U5.16 (GND)
M1A: ENC1.2 (ENCA), U1.5 (GPIO5/ADC1_CH4)
M1B: ENC1.3 (ENCB), U1.6 (GPIO6/ADC1_CH5)
M2A: ENC2.2 (ENCA), U1.7 (GPIO7/ADC1_CH6)
M2B: ENC2.3 (ENCB), U1.8 (GPIO15/ADC2_CH4/32K_P)
M3A: ENC3.2 (ENCA), U1.9 (GPIO16/ADC2_CH5/32K_N)
M3B: ENC3.3 (ENCB), U1.10 (GPIO17/ADC2_CH6)
M4A: ENC4.2 (ENCA), U1.11 (GPIO18/ADC2_CH7)
M4B: ENC4.3 (ENCB), U1.20 (GPIO14/ADC2_CH3)
MISO: SPI.4 (MISO), U1.19 (GPIO13/ADC2_CH2)
MOSI: SPI.5 (MOSI), U1.17 (GPIO11/ADC2_CH0)
NCS: SPI.3 (NCS), U1.16 (GPIO10/ADC1_CH9)
unnamed: 150.2, D1.1 (K)
PWMM1: U1.41 (GPIO1/ADC1_CH0), U4.9 (PWMA)
PWMM2: U1.40 (GPIO2/ADC1_CH1), U4.15 (PWMB)
PWMM3: U1.38 (GPIO41/MTDI), U5.9 (PWMA)
PWMM4: U1.39 (GPIO42/MTMS), U5.15 (PWMB)
SCL: 4.7k#2.2, I2C.3 (SCL), U1.15 (GPIO9/ADC1_CH8)
SCLK: SPI.6 (SCLK), U1.18 (GPIO12/ADC2_CH1)
SDA: 4.7k.2, I2C.4 (SDA), U1.12 (GPIO8/ADC1_CH7)
SVM: SERVO.3 (-), U1.25 (GPIO19/USB_D-)
VM1+: M1.1 (V+), U4.4 (A01)
VM1-: M1.2 (V-), U4.5 (A02)
VM2+: M2.1 (V+), U4.7 (B01)
VM2-: M2.2 (V-), U4.6 (B02)
VM3+: M3.1 (V+), U5.4 (A01)
VM3-: M3.2 (V-), U5.5 (A02)
VM4+: M4.1 (V+), U5.7 (B01)
VM4-: M4.2 (V-), U5.6 (B02)
V_BAT+: 100k.1, BAT.1
